Kreyl/BmstuCtrlTree/Docs/Инициализация HMC821.docx

#include "stm32f10x.h"

#include "stm32f10x_gpio.h"

#include "stm32f10x_rcc.h"

// Псевдоним вкл/выкл синего светодиода (LEB BLUE)

#define LED_BLUE_OFF GPIOC->BSRR = GPIO_BSRR_BR8

#define LED_BLUE_ON GPIOC->BSRR = GPIO_BSRR_BS8

// Псевдоним вкл/выкл зелёного светодиода LED GREEN

#define LED_GREEN_OFF GPIOC->BSRR = GPIO_BSRR_BR9

#define LED_GREEN_ON GPIOC->BSRR = GPIO_BSRR_BS9

// Удобные псевдонимы контактов HMC821

#define SCK_LOW GPIOA->BSRR = GPIO_BSRR_BR5

#define SCK_HIGH GPIOA->BSRR = GPIO_BSRR_BS5

#define SDI_LOW GPIOA->BSRR = GPIO_BSRR_BR7

#define SDI_HIGH GPIOA->BSRR = GPIO_BSRR_BS7

#define SEN_LOW GPIOA->BSRR = GPIO_BSRR_BR8

#define SEN_HIGH GPIOA->BSRR = GPIO_BSRR_BS8

// Инициализация контактов GPIO для управления HMC821

void initGpioForHMC821(void)

{

GPIO_InitTypeDef GPIO_InitStructure;

// Enable the Clock

RCC_APB2PeriphClockCmd(RCC_APB2Periph_GPIOA, ENABLE);

// Configure the GPIO pins

GPIO_InitStructure.GPIO_Pin = GPIO_Pin_5|GPIO_Pin_6|GPIO_Pin_7|GPIO_Pin_8;

GPIO_InitStructure.GPIO_Mode = GPIO_Mode_Out_PP; // ПРОВЕРИТЬ КОРРЕКТНОСТЬ!

GPIO_InitStructure.GPIO_Speed = GPIO_Speed_50MHz;

GPIO_Init(GPIOA, &GPIO_InitStructure);

}

// Инициализация GPIO для управления светодиодами на STM32F1discovery

void initGpioForDiscoveryLeds(void)

{

// Initialize Leds mounted on STM32 board

GPIO_InitTypeDef GPIO_InitStructure;

// Initialize LED which connected to PC6,9, Enable the Clock

RCC_APB2PeriphClockCmd(RCC_APB2Periph_GPIOC, ENABLE);

// Configure the GPIO_LED pin

GPIO_InitStructure.GPIO_Pin = GPIO_Pin_8|GPIO_Pin_9;

GPIO_InitStructure.GPIO_Mode = GPIO_Mode_Out_PP;

GPIO_InitStructure.GPIO_Speed = GPIO_Speed_50MHz;

GPIO_Init(GPIOC, &GPIO_InitStructure);

}

// Временная задержка

void delay(int time){

for (int i=0; i<time; i++);

}

// функция выполняет отправку команд в HMC821 через GPIO

// addr - адрес регистра

// data - данные регистра

void writeReg(unsigned char addr, int data)

{

// Константа определяет скорость программирования HMC821

const int SPEED = 10;

SCK_LOW;

SDI_LOW;

SEN_HIGH;

delay(SPEED/2);

SCK_HIGH;

delay(SPEED);

SCK_LOW;

// address

for(int i = 0;i<6;i++){

if( ((addr>>(5-i))&0x01) == 1 ) SDI_HIGH; else SDI_LOW;

delay(SPEED/2);

SCK_HIGH;

delay(SPEED);

SCK_LOW;

delay(SPEED/2);

}

// data

for(int i = 0;i<24;i++){

if( ((data>>(23-i))&0x01) == 1 ) SDI_HIGH; else SDI_LOW;

delay(SPEED/2);

SCK_HIGH;

delay(SPEED);

SCK_LOW;

delay(SPEED/2);

}

// clock 32

delay(SPEED/2);

SCK_HIGH;

delay(SPEED);

SCK_LOW;

delay(SPEED/2);

SEN_LOW;

delay(50*SPEED);

}

// Инициализация HMC821

// Для выбора правильных настроек и правильного задания порядка

// регистров - см. datasheet на HMC821

void initHMC821(void)

{

// Настройки для работы от опоры 100 МГц (pfd=50 МГц) и

// выходной частоты 3712,5 МГц

writeReg(0x0, 0x20);

writeReg(0x1, 0x2);

writeReg(0x2, 0x2);

writeReg(0x5, 0xE80D);

writeReg(0x5, 0x8395);

writeReg(0x5, 0xD11D);

writeReg(0x5, 0x5);

writeReg(0x3, 0x25); //INT 37

writeReg(0x4, 0x200000);

}

//{

// Настройки для работы от опоры 100 МГц (pfd=100 МГц) и

// выходной частоты 1800 МГц

//writeReg(0x0, 0x20);

//writeReg(0x1, 0x2);

//writeReg(0x2, 0x1);

//writeReg(0x5, 0xE80D);

//writeReg(0x5, 0x8B95);

//writeReg(0x5, 0xD11D);

//writeReg(0x5, 0x5);

//writeReg(0x3, 0x12); //INT 18

//writeReg(0x4, 0x00);

//}

int main(void)

{

// Задать GPIO для управления светодиодами (индикация состояния)

initGpioForDiscoveryLeds();

// Задать контакты GPIO, предназначенные для управления HMC821

initGpioForHMC821();

// в этой функции выполняется выдача команд по настройке HMC821

initHMC821();

// Зажечь зелёный светодиод и потушить синий - индикация окончания

// процедуры управления синтезатором

LED_BLUE_OFF;

LED_GREEN_ON;

}
