Kreyl/BmstuCtrlTree/CtrlTree_hw/CtrlTree.kicad_pcb

## KiCad design CtrlTree_hw/CtrlTree.kicad_pcb (2020-07-13)

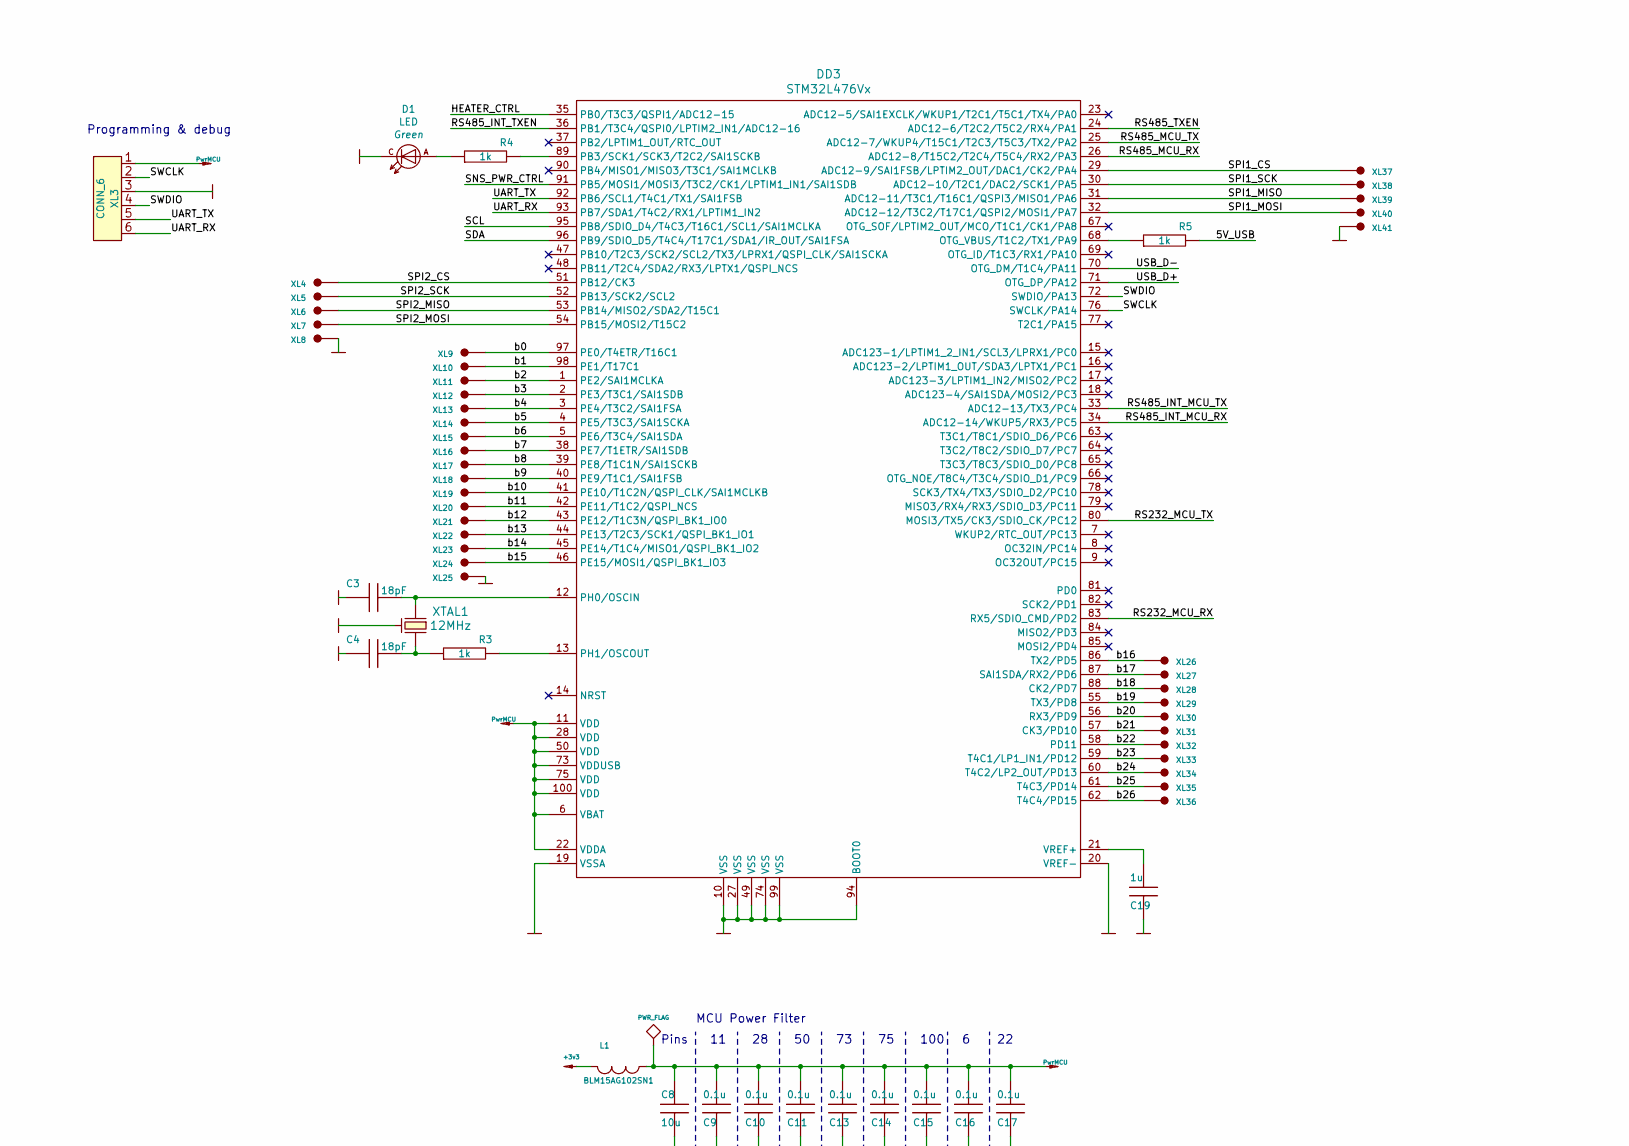
[picture p7: schematic CtrlTree.kicad_sch, part in row 1, column 1]

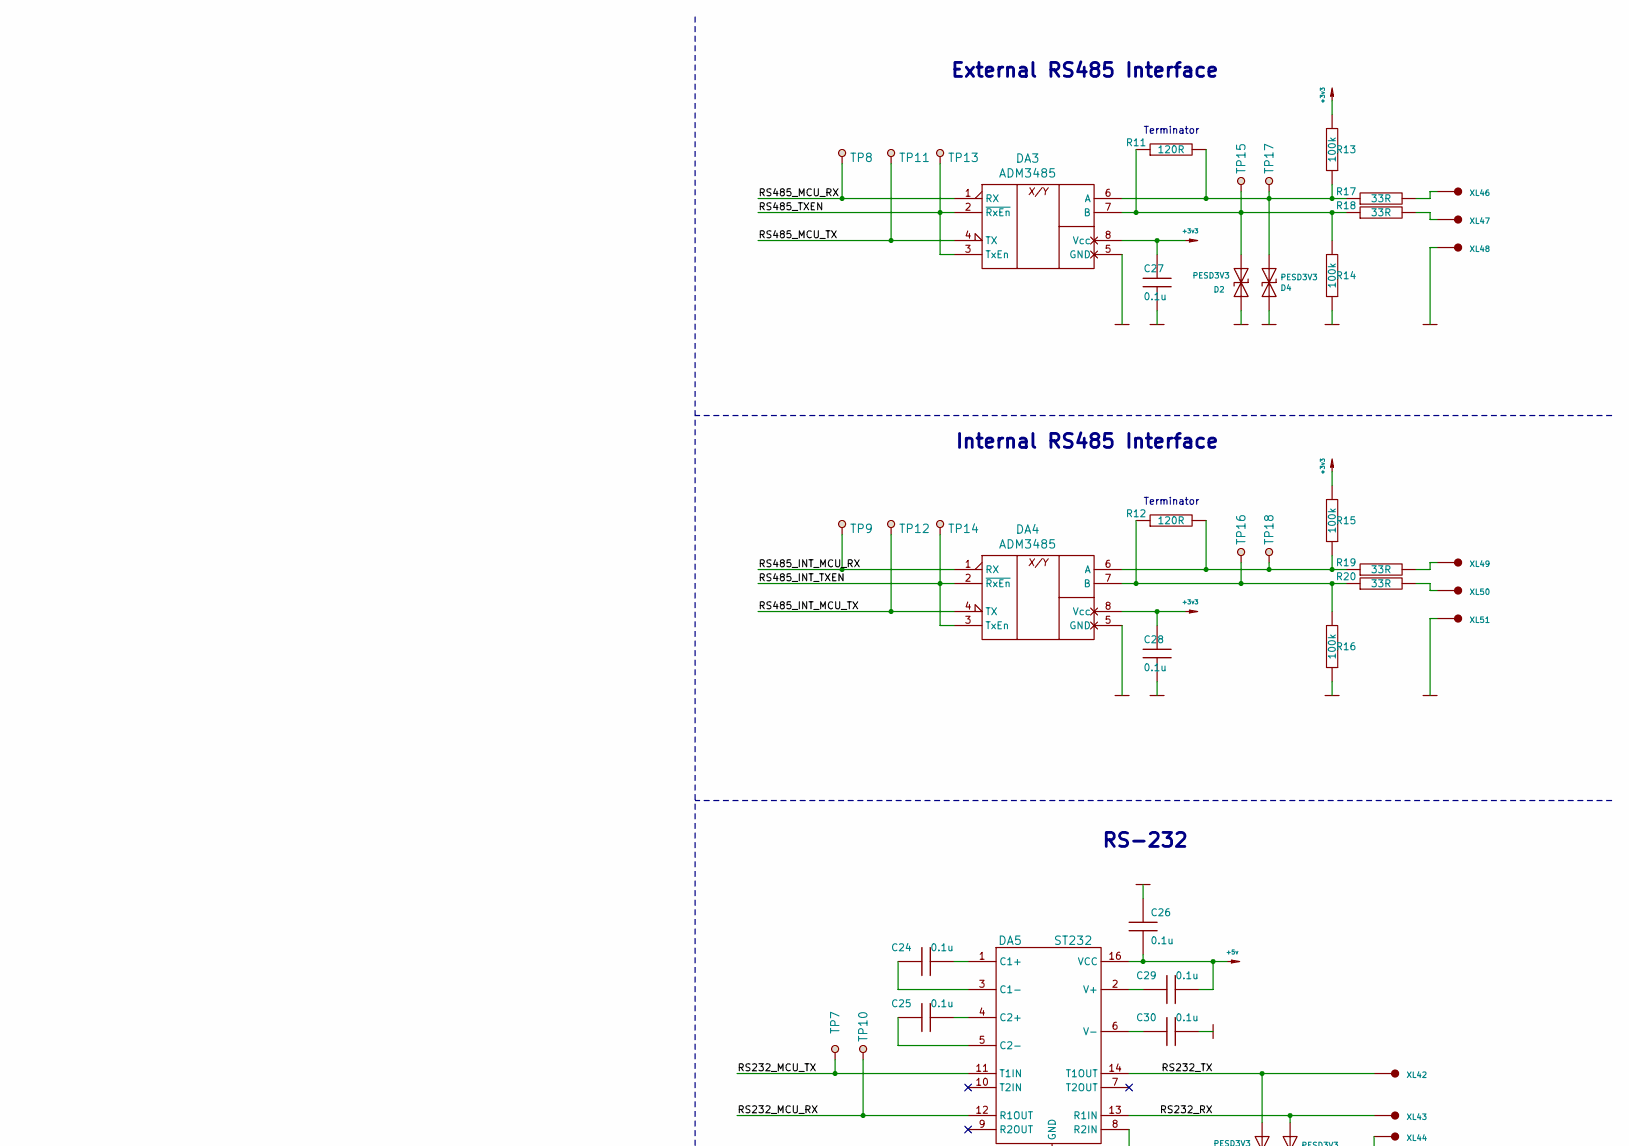
[picture p8: schematic CtrlTree.kicad_sch, part in row 1, column 2]

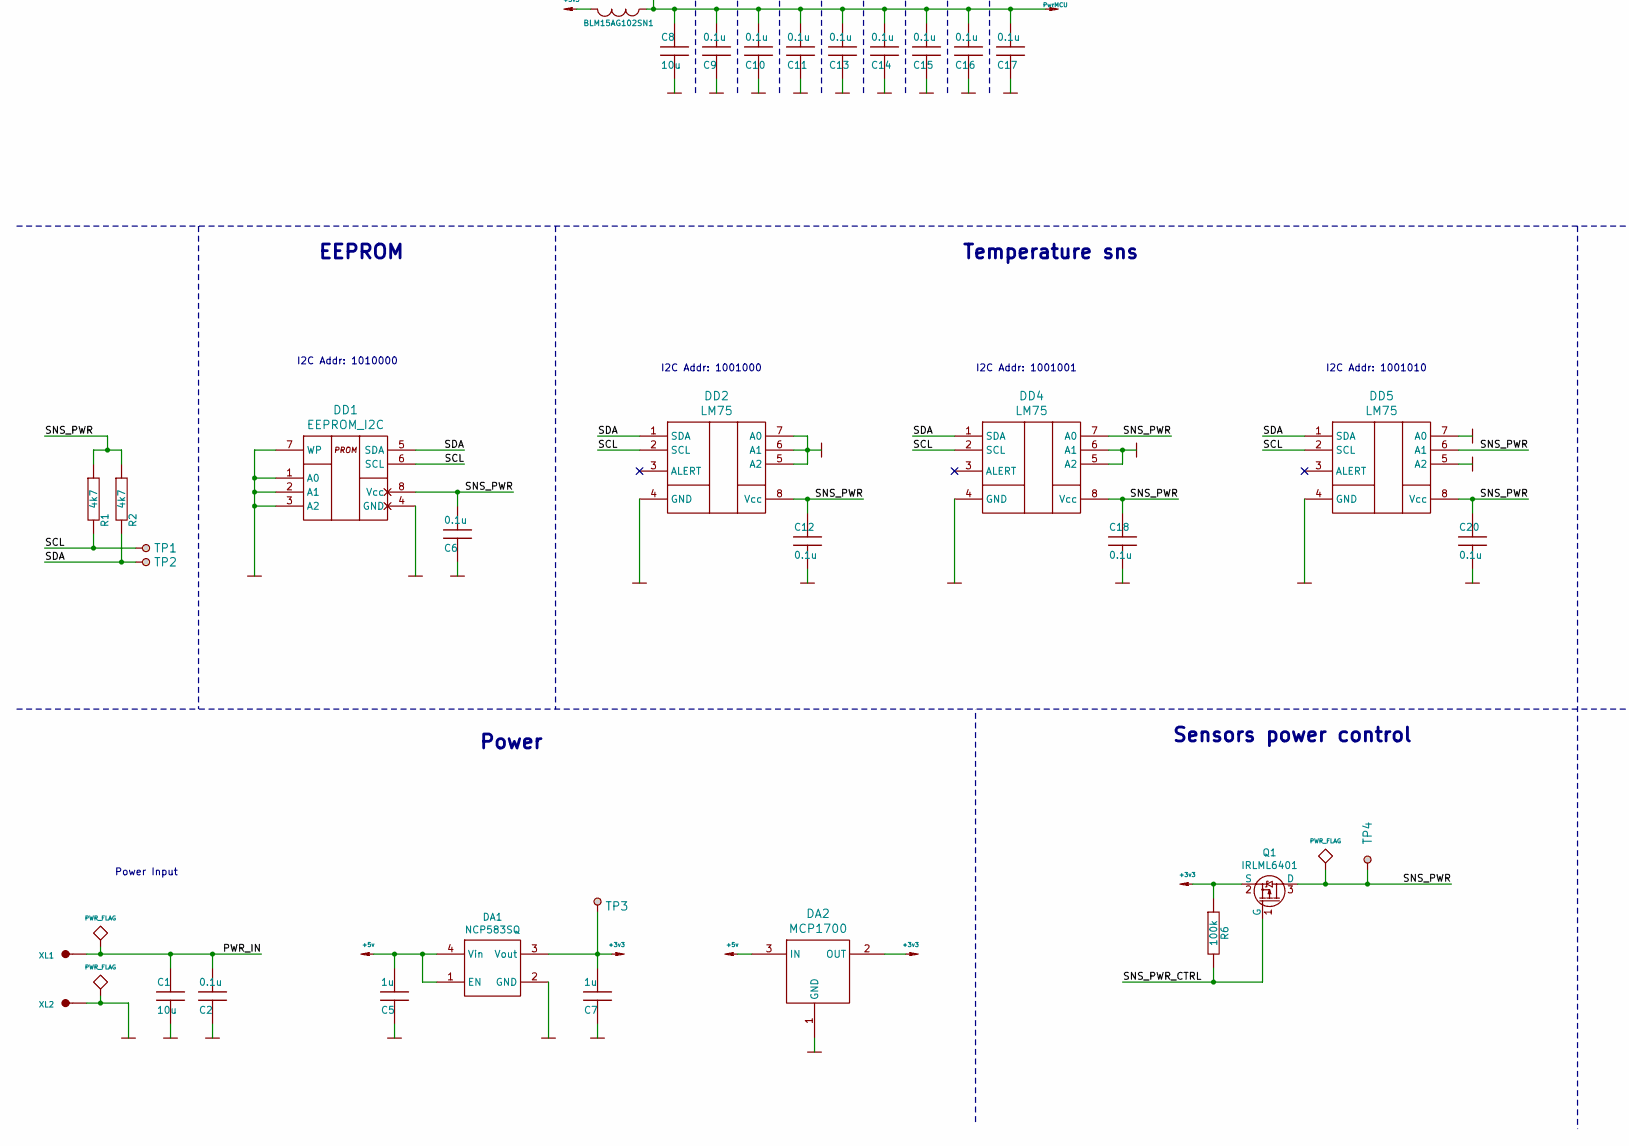
[picture p9: schematic CtrlTree.kicad_sch, part in row 2, column 1]

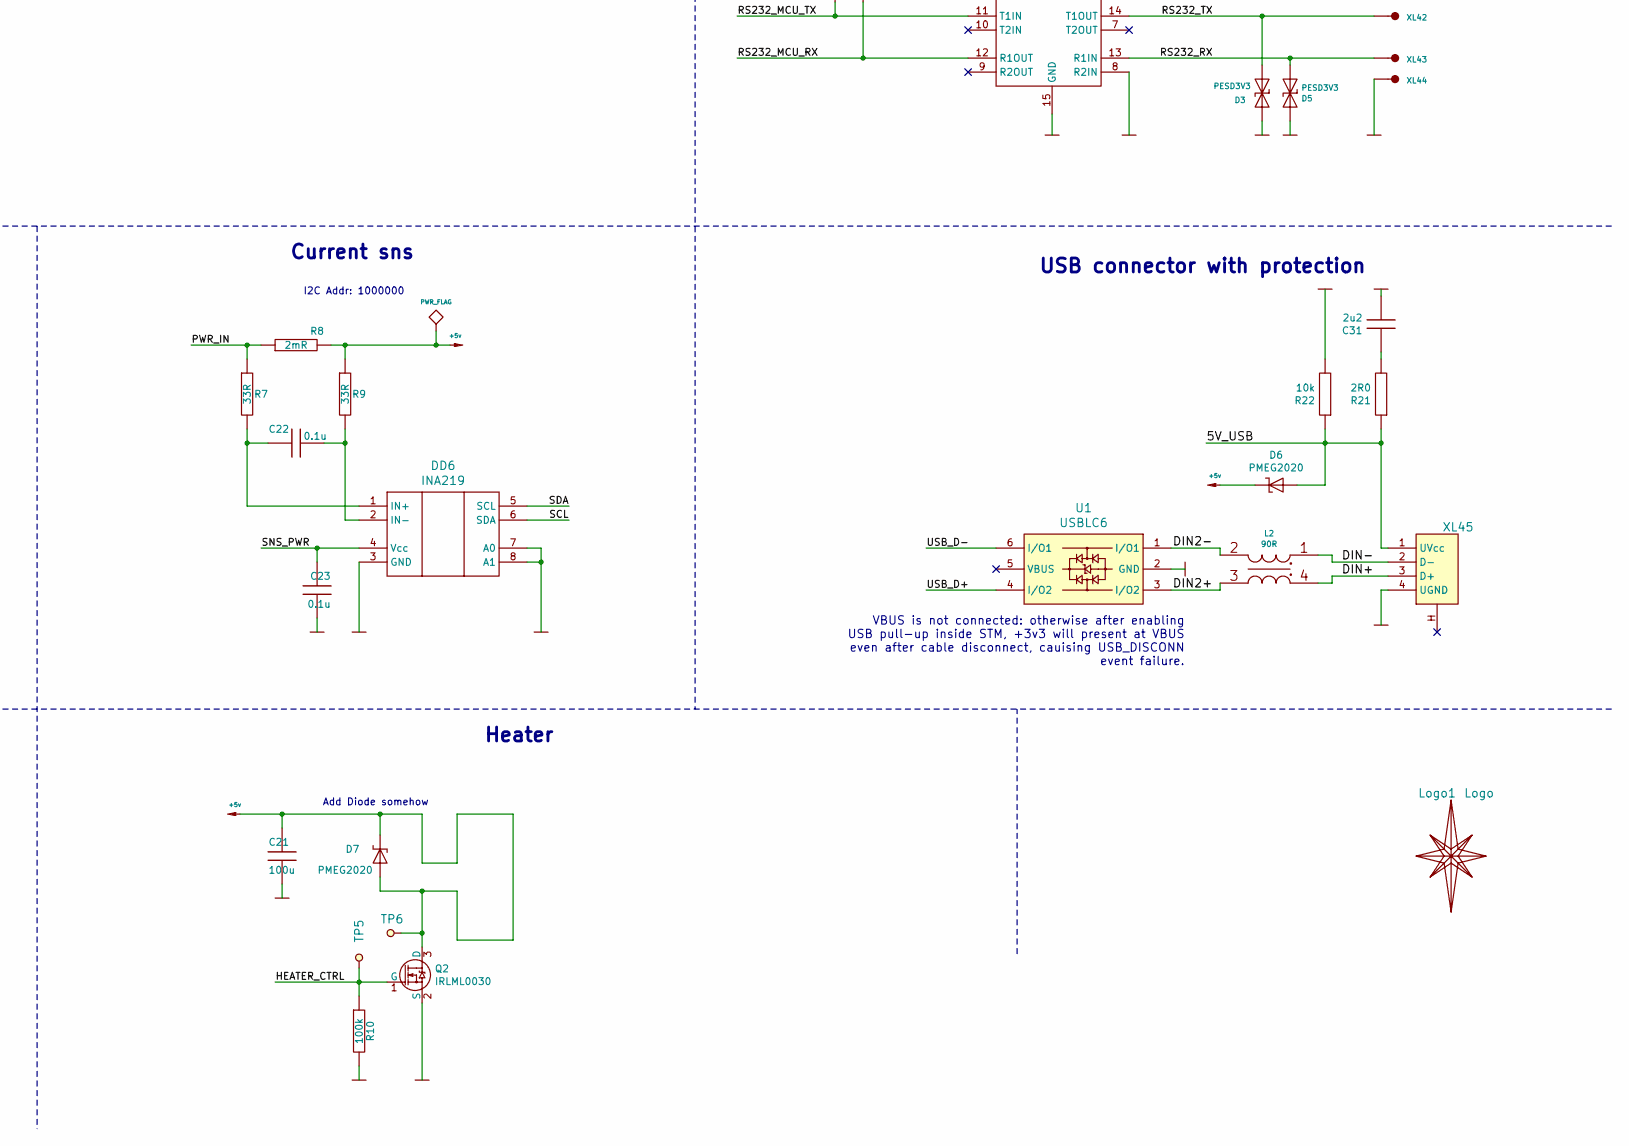
[picture p10: schematic CtrlTree.kicad_sch, part in row 2, column 2]

Parts:
C1, C8: 10u; CAP_0603_Silks
C2, C6, C9, C10, C11, C12, C13, C14, C15, C16, C17, C18, C20, C22, C23, C24, C25, C26, C27, C28, C29, C30: 0.1u; CAP_0603_Silks
C3, C4: 18pF; CAP_0603_Silks
C5, C7, C19: 1u; CAP_0603_Silks
C21: 100u; CAP_1206
C31: 2u2; CAP_0603_Silks
D1: LED; LED_0603
D2, D3, D4, D5: PESD3V3; SOD323
D6, D7: PMEG2020; SOD323
DA1: NCP583SQ; SC82AB
DA2: MCP1700; SOT23-3A
DA3, DA4: ADM3485; SO8_150MIL
DA5: ST232; SO16_150MIL
DD1: EEPROM_I2C; SO8_150MIL
DD2, DD4, DD5: LM75; SO8_150MIL
DD3: STM32L476Vx; LQFP100
DD6: INA219; SOT23-8
L1: BLM15AG102SN1; IND_0402
L2: 90R; DLW21SN
Logo1: Logo; Ostranna_12d7_10d1
Q1: IRLML6401; SOT23-3
Q2: IRLML0030; SOT23-3
R1, R2: 4k7; RES_0603
R3, R4, R5: 1k; RES_0603
R6, R10, R13, R14, R15, R16: 100k; RES_0603
R7, R9, R17, R18, R19, R20: 33R; RES_0603
R8: 2mR; RES_2512
R11, R12: 120R; RES_0603
R21: 2R0; RES_0603
R22: 10k; RES_0603
TP1, TP2, TP3, TP4, TP5, TP6, TP7, TP8, TP9, TP10, TP11, TP12, TP13, TP14, TP15, TP16, TP17, TP18: TESTPOINT; TESTPOINT_1MM
U1: USBLC6; SOT23-6
XL1, XL2, XL4, XL5, XL6, XL7, XL8, XL9, XL10, XL11, XL12, XL13, XL14, XL15, XL16, XL17, XL18, XL19, XL20, XL21, XL22, XL23, XL24, XL25, XL26, XL27, XL28, XL29, XL30, XL31, XL32, XL33, XL34, XL35, XL36, XL37, XL38, XL39, XL40, XL41, XL42, XL43, XL44, XL46, XL47, XL48, XL49, XL50, XL51: CONN_GOST_1; Oval3x1.5
XL3: CONN_6; PLS-6_LOCK
XL45: USB_MICRO_2H; USB_B
XTAL1: 12MHz; 03225C4

Connections:
+3v3: C7.1, C27.2, C28.2, DA1.3 (Vout), DA2.2 (OUT), DA3.8 (Vcc), DA4.8 (Vcc), L1.2, Q1.2 (S), R6.1, R13.1, R15.1, TP3.1
+5v: C5.1, C21.2, C26.2, C29.2, D6.C, D7.A, D7.C, DA1.1 (EN), DA1.4 (Vin), DA2.3 (IN), DA5.16 (VCC), Q2.3 (D), R8.2, R9.1, TP6.1
/5V_USB: D6.A, R5.2, R21.1, R22.1, XL45.1 (UVcc)
/DIN2+: L2.3, U1.3 (I/O2)
/DIN2-: L2.2, U1.1 (I/O1)
/DIN+: L2.4, XL45.3 (D+)
/DIN-: L2.1, XL45.2 (D-)
/HEATER_CTRL: DD3.35 (PB0/T3C3/QSPI1/ADC12-15), Q2.1 (G), R10.1, TP5.1
/PWR_IN: C1.2, C2.1, R7.1, R8.1, XL1.1
/RS232_MCU_RX: DA5.12 (R1OUT), DD3.83 (RX5/SDIO_CMD/PD2), TP10.1
/RS232_MCU_TX: DA5.11 (T1IN), DD3.80 (MOSI3/TX5/CK3/SDIO_CK/PC12), TP7.1
/RS232_RX: D5.C, DA5.13 (R1IN), XL43.1
/RS232_TX: D3.C, DA5.14 (T1OUT), XL42.1
/RS485_INT_MCU_RX: DA4.1 (RX), DD3.34 (ADC12-14/WKUP5/RX3/PC5), TP9.1
/RS485_INT_MCU_TX: DA4.4 (TX), DD3.33 (ADC12-13/TX3/PC4), TP12.1
/RS485_INT_TXEN: DA4.2 (~RxEn), DA4.3 (TxEn), DD3.36 (PB1/T3C4/QSPI0/LPTIM2_IN1/ADC12-16), TP14.1
/RS485_MCU_RX: DA3.1 (RX), DD3.26 (ADC12-8/T15C2/T2C4/T5C4/RX2/PA3), TP8.1
/RS485_MCU_TX: DA3.4 (TX), DD3.25 (ADC12-7/WKUP4/T15C1/T2C3/T5C3/TX2/PA2), TP11.1
/RS485_TXEN: DA3.2 (~RxEn), DA3.3 (TxEn), DD3.24 (ADC12-6/T2C2/T5C2/RX4/PA1), TP13.1
/SCL: DD1.6 (SCL), DD2.2 (SCL), DD3.95 (PB8/SDIO_D4/T4C3/T16C1/SCL1/SAI1MCLKA), DD4.2 (SCL), DD5.2 (SCL), DD6.6 (SDA), R1.2, TP1.1
/SDA: DD1.5 (SDA), DD2.1 (SDA), DD3.96 (PB9/SDIO_D5/T4C4/T17C1/SDA1/IR_OUT/SAI1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), DD4.1 (SDA), DD5.1 (SDA), DD6.5 (SCL), R2.2, TP2.1
/SNS_PWR: C6.1, C12.2, C18.2, C20.2, C23.2, DD1.8 (Vcc), DD2.8 (Vcc), DD4.7 (A0), DD4.8 (Vcc), DD5.6 (A1), DD5.8 (Vcc), DD6.4 (Vcc), Q1.3 (D), R1.1, R2.1, TP4.1
/SNS_PWR_CTRL: DD3.91 (PB5/MOSI1/MOSI3/T3C2/CK1/LPTIM1_IN1/SAI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), Q1.1 (G), R6.2
/SPI1_CS: DD3.29 (ADC12-9/SAI1FSB/LPTIM2_OUT/DAC1/CK2/PA4), XL37.1
/SPI1_MISO: DD3.31 (ADC12-11/T3C1/T16C1/QSPI3/MISO1/PA6), XL39.1
/SPI1_MOSI: DD3.32 (ADC12-12/T3C2/T17C1/QSPI2/MOSI1/PA7), XL40.1
/SPI1_SCK: DD3.30 (ADC12-10/T2C1/DAC2/SCK1/PA5), XL38.1
/SPI2_CS: DD3.51 (PB12/CK3), XL4.1
/SPI2_MISO: DD3.53 (PB14/MISO2/SDA2/T15C1), XL6.1
/SPI2_MOSI: DD3.54 (PB15/MOSI2/T15C2), XL7.1
/SPI2_SCK: DD3.52 (PB13/SCK2/SCL2), XL5.1
/SWCLK: DD3.76 (SWCLK/PA14), XL3.2
/SWDIO: DD3.72 (SWDIO/PA13), XL3.4
/UART_RX: DD3.93 (PB7/SDA1/T4C2/RX1/LPTIM1_IN2), XL3.6
/UART_TX: DD3.92 (PB6/SCL1/T4C1/TX1/SAI1FSB), XL3.5
/USB_D+: DD3.71 (OTG_DP/PA12), U1.4 (I/O2)
/USB_D-: DD3.70 (OTG_DM/T1C4/PA11), U1.6 (I/O1)
/b0: DD3.97 (PE0/T4ETR/T16C1), XL9.1
/b1: DD3.98 (PE1/T17C1), XL10.1
/b2: DD3.1 (PE2/SAI1MCLKA), XL11.1
/b3: DD3.2 (PE3/T3C1/SAI1SDB), XL12.1
/b4: DD3.3 (PE4/T3C2/SAI1FSA), XL13.1
/b5: DD3.4 (PE5/T3C3/SAI1SCKA), XL14.1
/b6: DD3.5 (PE6/T3C4/SAI1SDA), XL15.1
/b7: DD3.38 (PE7/T1ETR/SAI1SDB), XL16.1
/b8: DD3.39 (PE8/T1C1N/SAI1SCKB), XL17.1
/b9: DD3.40 (PE9/T1C1/SAI1FSB), XL18.1
/b10: DD3.41 (PE10/T1C2N/QSPI_CLK/SAI1MCLKB), XL19.1
/b11: DD3.42 (PE11/T1C2/QSPI_NCS), XL20.1
/b12: DD3.43 (PE12/T1C3N/QSPI_BK1_IO0), XL21.1
/b13: DD3.44 (PE13/T2C3/SCK1/QSPI_BK1_IO1), XL22.1
/b14: DD3.45 (PE14/T1C4/MISO1/QSPI_BK1_IO2), XL23.1
/b15: DD3.46 (PE15/MOSI1/QSPI_BK1_IO3), XL24.1
/b16: DD3.86 (TX2/PD5), XL26.1
/b17: DD3.87 (SAI1SDA/RX2/PD6), XL27.1
/b18: DD3.88 (CK2/PD7), XL28.1
/b19: DD3.55 (TX3/PD8), XL29.1
/b20: DD3.56 (RX3/PD9), XL30.1
/b21: DD3.57 (CK3/PD10), XL31.1
/b22: DD3.58 (PD11), XL32.1
/b23: DD3.59 (T4C1/LP1_IN1/PD12), XL33.1
/b24: DD3.60 (T4C2/LP2_OUT/PD13), XL34.1
/b25: DD3.61 (T4C3/PD14), XL35.1
/b26: DD3.62 (T4C4/PD15), XL36.1
GND: C1.1, C2.2, C3.2, C4.2, C5.2, C6.2, C7.2, C8.1, C9.2, C10.2, C11.2, C12.1, C13.2, C14.2, C15.2, C16.2, C17.2, C18.1, C19.2, C20.1, C21.1, C23.1, C26.1, C27.1, C28.1, C30.2, C31.2, D1.C, D2.A, D3.A, D4.A, D5.A, DA1.2 (GND), DA2.1 (GND), DA3.5 (GND), DA4.5 (GND), DA5.8 (R2IN), DA5.15 (GND), DD1.1 (A0), DD1.2 (A1), DD1.3 (A2), DD1.4 (GND), DD1.7 (WP), DD2.4 (GND), DD2.5 (A2), DD2.6 (A1), DD2.7 (A0), DD3.10 (VSS), DD3.19 (VSSA), DD3.20 (VREF-), DD3.27 (VSS), DD3.49 (VSS), DD3.74 (VSS), DD3.94 (BOOT0), DD3.99 (VSS), DD4.4 (GND), DD4.5 (A2), DD4.6 (A1), DD5.4 (GND), DD5.5 (A2), DD5.7 (A0), DD6.3 (GND), DD6.7 (A0), DD6.8 (A1), Q2.2 (S), R10.2, R14.2, R16.2, R22.2, U1.2 (GND), XL2.1, XL3.3, XL8.1, XL25.1, XL41.1, XL44.1, XL45.4 (UGND), XL48.1, XL51.1, XTAL1.H
unnamed: C3.1, DD3.12 (PH0/OSCIN), XTAL1.1
unnamed: C4.1, R3.1, XTAL1.2
unnamed: C19.1, DD3.21 (VREF+)
unnamed: C22.1, DD6.2 (IN-), R9.2
unnamed: C22.2, DD6.1 (IN+), R7.2
unnamed: C24.1, DA5.3 (C1-)
unnamed: C24.2, DA5.1 (C1+)
unnamed: C25.1, DA5.5 (C2-)
unnamed: C25.2, DA5.4 (C2+)
unnamed: C29.1, DA5.2 (V+)
unnamed: C30.1, DA5.6 (V-)
unnamed: C31.1, R21.2
unnamed: D1.A, R4.1
unnamed: D2.C, DA3.7 (B), R11.1, R14.1, R18.1, TP15.1
unnamed: D4.C, DA3.6 (A), R11.2, R13.2, R17.1, TP17.1
unnamed: DA4.6 (A), R12.2, R15.2, R19.1, TP18.1
unnamed: DA4.7 (B), R12.1, R16.1, R20.1, TP16.1
unnamed: DD3.13 (PH1/OSCOUT), R3.2
unnamed: DD3.68 (OTG_VBUS/T1C2/TX1/PA9), R5.1
unnamed: DD3.89 (PB3/SCK1/SCK3/T2C2/SAI1SCKB), R4.2
unnamed: R17.2, XL46.1
unnamed: R18.2, XL47.1
unnamed: R19.2, XL49.1
unnamed: R20.2, XL50.1
PwrMCU: C8.2, C9.1, C10.1, C11.1, C13.1, C14.1, C15.1, C16.1, C17.1, DD3.6 (VBAT), DD3.11 (VDD), DD3.22 (VDDA), DD3.28 (VDD), DD3.50 (VDD), DD3.73 (VDDUSB), DD3.75 (VDD), DD3.100 (VDD), L1.1, XL3.1

Notes on the sheet:
Programming & debug
Power Input
I2C Addr: 1010000
EEPROM
Power
Pins
I2C Addr: 1001000
MCU Power Filter
100
Temperature sns
I2C Addr: 1001001
Sensors power control
I2C Addr: 1001010
Current sns
I2C Addr: 1000000
Add Diode somehow
Heater
RS-232
Terminator
VBUS is not connected: otherwise after enabling USB pull-up inside STM, +3v3 will present at VBUS even after cable disconnect, cauising USB_DISCONN event failure.
External RS485 Interface
Internal RS485 Interface
USB connector with protection

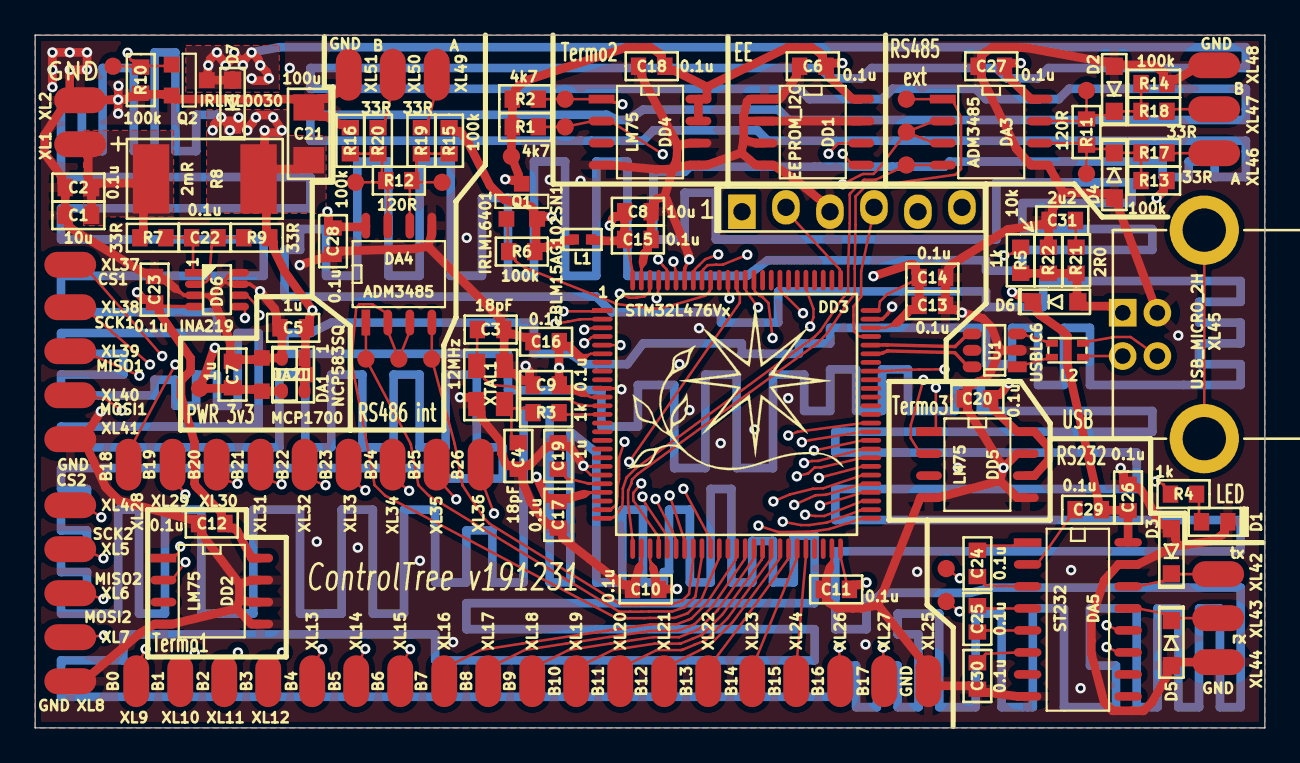
[picture p11: board CtrlTree.kicad_pcb from above]

Board: 4 copper layers, 71.0 x 40.0 mm, 147 parts (0 on the bottom side), 90 nets.
