Kreyl/BmstuCtrlTree/L476V/L476V.ioc

Mcu.UserName=STM32L476VGTx
PA1.Signal=USART2_DE
PA11.Signal=USB_OTG_FS_DM
PA12.Signal=USB_OTG_FS_DP
PA2.Signal=USART2_TX
PA3.Signal=USART2_RX
PA4.Signal=SPI1_NSS
PA5.Signal=SPI1_SCK
PA6.Signal=SPI1_MISO
PA7.Signal=SPI1_MOSI
PA9.Signal=USB_OTG_FS_VBUS
PB0.Signal=S_TIM3_CH3
PB1.Signal=USART3_DE
PB12.Signal=SPI2_NSS
PB13.Signal=SPI2_SCK
PB14.Signal=SPI2_MISO
PB15.Signal=SPI2_MOSI
PB5.Signal=UART5_CTS
PB6.Signal=USART1_TX
PB7.Signal=USART1_RX
PB8.Signal=I2C1_SCL
PB9.Signal=I2C1_SDA
PC12.Signal=UART5_TX
PC4.Signal=USART3_TX
PC5.Signal=USART3_RX
PD10.Signal=GPIO_Output
PD11.Signal=GPIO_Output
PD12.Signal=GPIO_Output
PD13.Signal=GPIO_Output
PD14.Signal=GPIO_Output
PD15.Signal=GPIO_Output
PD2.Signal=UART5_RX
PD5.Signal=GPIO_Output
PD6.Signal=GPIO_Output
PD7.Signal=GPIO_Output
PD8.Signal=GPIO_Output
PD9.Signal=GPIO_Output
PE0.Signal=GPIO_Output
PE1.Signal=GPIO_Output
PE10.Signal=GPIO_Output
PE11.Signal=GPIO_Output
PE12.Signal=GPIO_Output
PE13.Signal=GPIO_Output
PE14.Signal=GPIO_Output
PE15.Signal=GPIO_Output
PE2.Signal=GPIO_Output
PE3.Signal=GPIO_Output
PE4.Signal=GPIO_Output
PE5.Signal=GPIO_Output
PE6.Signal=GPIO_Output
PE7.Signal=GPIO_Output
PE8.Signal=GPIO_Output
PE9.Signal=GPIO_Output
