Kreyl/BmstuCtrlTree/CtrlTree_fw/Sequences.h

/*
 * Sequences.h
 *
 *  Created on: 09 ���. 2015 �.
 *      Author: Kreyl
 */

#pragma once

#include "ChunkTypes.h"

const BaseChunk_t lsqCmd[] = {
        {csSetup, 0},
        {csWait, 99},
        {csSetup, 1},
        {csEnd}
};

const BaseChunk_t lsqWriting[] = {
        {csSetup, 0},
        {csWait, 45},
        {csSetup, 1},
        {csWait, 45},
        {csSetup, 0},
        {csWait, 45},
        {csSetup, 1},
        {csWait, 540},
        {csGoto, 0}
};

#if 0 // ============================ LED blink ================================
const LedChunk_t lsqIdle[] = {
        {csSetup, 0, clBlack},
        {csEnd}
};

const LedChunk_t lsqError[] = {
        {csSetup, 0, clRed},
        {csWait, 4005},
        {csSetup, 0, clBlack},
        {csEnd}
};

// ======= Adding / removing IDs ========
// ==== Access ====
#define LSQ_ACCESS_ADD_CLR      clGreen
#define LSQ_ACCESS_REMOVE_CLR   clRed
const LedChunk_t lsqAddingAccessWaiting[] = {
        {csSetup, 0, LSQ_ACCESS_ADD_CLR},
        {csEnd}
};
const LedChunk_t lsqAddingAccessNew[] = {
        {csSetup, 0, clBlack},
        {csWait, 180},
        {csSetup, 0, LSQ_ACCESS_ADD_CLR},
        {csEnd}
};
const LedChunk_t lsqAddingAccessError[] = {
        {csSetup, 0, clRed},
        {csWait, 99},
        {csSetup, 0, clBlack},
        {csWait, 99},
        {csSetup, 0, clRed},
        {csWait, 99},
        {csSetup, 0, clBlack},
        {csWait, 99},
        {csSetup, 0, clRed},
        {csWait, 99},
        {csSetup, 0, clBlack},
        {csWait, 99},
        {csSetup, 0, LSQ_ACCESS_ADD_CLR},
        {csEnd}
};

const LedChunk_t lsqRemovingAccessWaiting[] = {
        {csSetup, 0, LSQ_ACCESS_REMOVE_CLR},
        {csEnd}
};
const LedChunk_t lsqRemovingAccessNew[] = {
        {csSetup, 0, clBlack},
        {csWait, 180},
        {csSetup, 0, LSQ_ACCESS_REMOVE_CLR},
        {csEnd}
};

// ==== Adder ====
#define LSQ_ADDER_ADD_CLR       clBlue
#define LSQ_ADDER_REMOVE_CLR    clMagenta
const LedChunk_t lsqAddingAdderWaiting[] = {
        {csSetup, 0, LSQ_ADDER_ADD_CLR},
        {csEnd}
};
const LedChunk_t lsqAddingAdderNew[] = {
        {csSetup, 0, clBlack},
        {csWait, 180},
        {csSetup, 0, LSQ_ADDER_ADD_CLR},
        {csEnd}
};
const LedChunk_t lsqAddingAdderError[] = {
        {csSetup, 0, clRed},
        {csWait, 99},
        {csSetup, 0, clBlack},
        {csWait, 99},
        {csSetup, 0, clRed},
        {csWait, 99},
        {csSetup, 0, clBlack},
        {csWait, 99},
        {csSetup, 0, clRed},
        {csWait, 99},
        {csSetup, 0, clBlack},
        {csWait, 99},
        {csSetup, 0, LSQ_ADDER_ADD_CLR},
        {csEnd}
};

const LedChunk_t lsqRemovingAdderWaiting[] = {
        {csSetup, 0, LSQ_ADDER_REMOVE_CLR},
        {csEnd}
};
const LedChunk_t lsqRemovingAdderNew[] = {
        {csSetup, 0, clBlack},
        {csWait, 180},
        {csSetup, 0, LSQ_ADDER_REMOVE_CLR},
        {csEnd}
};

// ==== Remover ====
#define LSQ_REMOVER_ADD_CLR     clCyan
#define LSQ_REMOVER_REMOVE_CLR  clYellow
const LedChunk_t lsqAddingRemoverWaiting[] = {
        {csSetup, 0, LSQ_REMOVER_ADD_CLR},
        {csEnd}
};
const LedChunk_t lsqAddingRemoverNew[] = {
        {csSetup, 0, clBlack},
        {csWait, 180},
        {csSetup, 0, LSQ_REMOVER_ADD_CLR},
        {csEnd}
};
const LedChunk_t lsqAddingRemoverError[] = {
        {csSetup, 0, clRed},
        {csWait, 99},
        {csSetup, 0, clBlack},
        {csWait, 99},
        {csSetup, 0, clRed},
        {csWait, 99},
        {csSetup, 0, clBlack},
        {csWait, 99},
        {csSetup, 0, clRed},
        {csWait, 99},
        {csSetup, 0, clBlack},
        {csWait, 99},
        {csSetup, 0, LSQ_REMOVER_ADD_CLR},
        {csEnd}
};

const LedChunk_t lsqRemovingRemoverWaiting[] = {
        {csSetup, 0, LSQ_REMOVER_REMOVE_CLR},
        {csEnd}
};
const LedChunk_t lsqRemovingRemoverNew[] = {
        {csSetup, 0, clBlack},
        {csWait, 180},
        {csSetup, 0, LSQ_REMOVER_REMOVE_CLR},
        {csEnd}
};

// ==== Erase all ====
const LedChunk_t lsqEraseAll[] = {
        {csSetup, 0, clRed},
        {csWait, 180},
        {csSetup, 0, clBlack},
        {csWait, 180},
        {csSetup, 0, clRed},
        {csWait, 180},
        {csSetup, 0, clBlack},
        {csWait, 180},
        {csSetup, 0, clRed},
        {csWait, 180},
        {csSetup, 0, clBlack},
        {csWait, 180},
        {csSetup, 0, clRed},
        {csWait, 180},
        {csSetup, 0, clBlack},
        {csEnd}
};

// General
const LedChunk_t lsqBlinkGreen[] = {
        {csSetup, 0, clGreen},
        {csWait, 180},
        {csSetup, 0, clBlack},
        {csEnd}
};

const LedChunk_t lsqBlinkGreenX2[] = {
        {csSetup, 0, clGreen},
        {csWait, 180},
        {csSetup, 0, clBlack},
        {csWait, 180},
        {csSetup, 0, clGreen},
        {csWait, 180},
        {csSetup, 0, clBlack},
//        {csWait, 999},
//        {csGoto, 0}
        {csEnd}
};
#endif

#if 0 // ============================ LED RGB ==================================
const LedRGBChunk_t lsqStart[] = {
        {csSetup, 90, clRed},
        {csSetup, 90, clGreen},
        {csSetup, 90, clBlue},
        {csSetup, 90, {0, 2, 0}},
        {csEnd}
};

const LedRGBChunk_t lsqFailure[] = {
        {csSetup, 0, clRed},
        {csWait, 90},
        {csSetup, 0, clRed},
        {csWait, 90},
        {csSetup, 0, clRed},
        {csWait, 90},
        {csSetup, 0, clRed},
        {csWait, 90},
        {csSetup, 0, clRed},
        {csWait, 90},
        {csSetup, 0, clRed},
        {csWait, 90},
        {csEnd}
};

const LedRGBChunk_t lsqCharging[] = {
        {csSetup, 360, clBlue},
        {csSetup, 360, clBlack},
        {csGoto, 0}
};

const LedRGBChunk_t lsqOperational[] = {
        {csSetup, 90, {0, 2, 0}},
        {csEnd}
};

//const LedRGBChunk_t lsqCharging[] = {
//        {csSetup, 540, {0,9,0}},
//        {csSetup, 540, clBlack},
//        {csWait, 900},
//        {csGoto, 0}
//};
//
//const LedRGBChunk_t lsqChargingDone[] = {
//        {csSetup, 0, {0,9,0}},
//        {csEnd}
//};
//
//const LedRGBChunk_t lsqDischarged[] = {
//        {csSetup, 0, clRed},
//        {csWait, 180},
//        {csSetup, 0, clBlack},
//        {csWait, 360},
//        {csGoto, 0}
//};
#endif

#if 0 // =========================== LED Smooth ================================
#define LED_TOP_BRIGHTNESS  101

const LedSmoothChunk_t lsqSmoothFadein[] = {
        {csSetup, 180, LED_TOP_BRIGHTNESS},
        {csEnd}
};

const LedSmoothChunk_t lsqSmoothFailure[] = {
        {csSetup, 0, LED_TOP_BRIGHTNESS},
        {csWait, 72},
        {csSetup, 0, 0},
        {csWait, 72},
        {csGoto, 0}
};

const LedSmoothChunk_t lsqSmoothFadeout[] = {
        {csSetup, 180, 0},
        {csEnd}
};

const LedSmoothChunk_t lsqSmoothDischarged[] = {
        {csSetup, 0, LED_TOP_BRIGHTNESS},
        {csWait, 207},
        {csSetup, 0, 0},
        {csWait, 207},
        {csGoto, 0}
};
const LedSmoothChunk_t lsq5VNotCharging[] = {
        {csSetup, 0, LED_TOP_BRIGHTNESS},
        {csEnd}
};
const LedSmoothChunk_t lsq5VCharging[] = {
        {csSetup, 360, LED_TOP_BRIGHTNESS},
        {csSetup, 360, 4},
        {csGoto, 0}
};

#endif

#if 0 // ============================= Beeper ==================================
#define BEEP_VOLUME     1   // Maximum 10

#if 1 // ==== Notes ====
#define La_2    880

#define Do_3    1047
#define Do_D_3  1109
#define Re_3    1175
#define Re_D_3  1245
#define Mi_3    1319
#define Fa_3    1397
#define Fa_D_3  1480
#define Sol_3   1568
#define Sol_D_3 1661
#define La_3    1720
#define Si_B_3  1865
#define Si_3    1976

#define Do_4    2093
#define Do_D_4  2217
#define Re_4    2349
#define Re_D_4  2489
#define Mi_4    2637
#define Fa_4    2794
#define Fa_D_4  2960
#define Sol_4   3136
#define Sol_D_4 3332
#define La_4    3440
#define Si_B_4  3729
#define Si_4    3951

// Length
#define OneSixteenth    90
#define OneEighth       (OneSixteenth * 2)
#define OneFourth       (OneSixteenth * 4)
#define OneHalfth       (OneSixteenth * 8)
#define OneWhole        (OneSixteenth * 16)
#endif

// MORSE
#define MORSE_TONE {csSetup, BEEP_VOLUME, Do_3}
#define MORSE_DOT_LENGTH 180
#define MORSE_DASH_LENGTH MORSE_DOT_LENGTH * 3
#define MORSE_PAUSE_LENGTH MORSE_DOT_LENGTH
#define MORSE_PAUSE {csSetup, 0}, {csWait, MORSE_PAUSE_LENGTH}
#define MORSE_DOT MORSE_TONE, {csWait, MORSE_DOT_LENGTH}, MORSE_PAUSE
#define MORSE_DASH MORSE_TONE, {csWait, MORSE_DASH_LENGTH}, MORSE_PAUSE

// Type, BEEP_VOLUME, freq
const BeepChunk_t bsqOn[] = {
        {csSetup, 10, 7000},
        {csEnd}
};

const BeepChunk_t bsqButton[] = {
        {csSetup, 1, 1975},
        {csWait, 54},
        {csSetup, 0},
        {csEnd}
};
const BeepChunk_t bsqBeepBeep[] = {
        {csSetup, BEEP_VOLUME, 1975},
        {csWait, 54},
        {csSetup, 0},
        {csWait, 54},
        {csSetup, BEEP_VOLUME, 1975},
        {csWait, 54},
        {csSetup, 0},
        {csEnd}
};

const BeepChunk_t bsqCharge[] = {
        MORSE_DOT, MORSE_DASH,
        {csEnd}
};
const BeepChunk_t bsqThrow[] = {
        MORSE_DOT,
        {csEnd}
};
const BeepChunk_t bsqPunch[] = {
        MORSE_DOT, MORSE_DASH, MORSE_DASH, MORSE_DOT,
        {csEnd}
};
const BeepChunk_t bsqLift[] = {
        MORSE_DOT, MORSE_DASH, MORSE_DOT, MORSE_DOT,
        {csEnd}
};
const BeepChunk_t bsqWarp[] = {
        MORSE_DOT, MORSE_DASH, MORSE_DASH,
        {csEnd}
};
const BeepChunk_t bsqBarrier[] = {
        MORSE_DASH, MORSE_DOT, MORSE_DOT, MORSE_DOT,
        {csEnd}
};
const BeepChunk_t bsqCleanse[] = {
        MORSE_DASH, MORSE_DOT, MORSE_DASH, MORSE_DOT,
        {csEnd}
};
const BeepChunk_t bsqSingular[] = {
        MORSE_DOT, MORSE_DOT, MORSE_DOT,
        {csEnd}
};
const BeepChunk_t bsqSong[] = {
        {csSetup, BEEP_VOLUME, Sol_3},
        {csWait, 360},
        {csSetup, BEEP_VOLUME, Mi_3},
        {csWait, 360},
        {csSetup, BEEP_VOLUME, Do_3},
        {csWait, 360},
        {csSetup, 0},
        {csEnd}
};
const BeepChunk_t bsqRelease[] = {
        MORSE_DOT, MORSE_DASH, MORSE_DOT,
        {csEnd}
};
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
