Kreyl/BmstuCtrlTree/(commit log)

2019-11-16 sch done
    [CtrlTree.kicad_pcb, CtrlTree.sch]
2019-12-30 Layout started
    [CtrlTree.kicad_pcb, CtrlTree.sch]
2019-12-31 + Gerbers ready
    [CtrlTree.kicad_pcb, CtrlTree.sch]
2020-05-02 * Switch to atollic + table management commands Not saved to EE, though
2020-05-03 + Receive file by UART + Transmit it by SPI
2020-05-04 + AddDevice and PutDevice change real device params
2020-05-17 + TControl
    [CtrlTree.sch]
2020-06-06 + Write regs and Save regs for HMC821 and ADF5356
    [CtrlTree.kicad_sch]
2020-07-13 + saveregs * RReply
    [CtrlTree.kicad_pcb, CtrlTree.kicad_sch]
2020-07-28 * Fixed Avg t bug
    [TControl.cpp, TControl.h, kl_lib.cpp, main.cpp]
